Spin7/Self_Balance_Robot_via_Feedback_State/3- Latex ZIP Projects/TPF_SCD_RobotBalancin_extracted/abstract.tex

In this final work, a model-based predictive control (MBPC) strategy is proposed for three-phase inverters in order to control the power delivered to the balanced/linear loads  for applications in distributed generation. Contrary to the classical control schemes, the proposed method does not require current proportional-integral controllers or a complex modulation stage. The discrete-time model of the inverter, filter and load are used to predict the future behavior of the load currents for each of the possible switching states. The proposed predictive method chooses a switching state that minimizes the error between the output currents and their references. The feasibility of the proposed method is verified in this first part, through simulation results, evaluating these results using performance parameters. The results obtained through simulations are compared with those obtained experimentally using a test platform designed as part of the final work. These results validate the excellent dynamic performance and efficiency of the proposed methods.
