Spin7/Self_Balance_Robot_via_Feedback_State/TPF_SCD_RobotBalancin.pdf

## Trabajo Practico Final ´ SISTEMAS DE CONTROL DIGITAL

Control de un Robot Balancín (Pendulo Invertido) Mediante Retroalimentaci ´ | on de Estados ´

Lucas Pina,1, Matteo Martineza,1, Franco de Vargasa,1, Dr. Ing. Leonardo Comparatoreb,1, MSc. Ing. Christian Medinab,1, MSc. Ing. Paola Maidanab,1

aEstudiante de Ingeniería Mecatrónica, Facultad de Ingeniería, Universidad Nacional de Asunción, CITEC-Luque, Paraguay
bOrientador, Facultad de Ingeniería, Universidad Nacional de Asunción, CITEC-Luque, Paraguay

Palabras clave

Control Optimo
LQR
Servo Sistema
Pendulo Invertido

Resumen

Se desarrolla el modelado y control de un robot balancín, considerado como un pendulo invertido ´
sobre ruedas. Se parte de la obtencion del modelo din ´ | amico mediante la formulaci ´ | on de Lagrange, ´
representando el sistema como cuerpos rígidos acoplados. Luego, se disena un controlador ˜ | optimo ´
LQR basado en realimentacion de estados, con el objetivo de estabilizar la posici ´ | on vertical ´
del sistema. Finalmente, se valida el desempeno del controlador en simulaci ˜ | on, demostrando su ´
efectividad ante distintas condiciones iniciales.

### 1. Introduccion´

“¡Contempla, caminante del filo, la danza de un cuerpo erguido contra la tiranía de la gravedad!”.

El control de sistemas inestables ha sido un tema central en la teoría de control moderno, destacando el pendulo ´ invertido como uno de los problemas mas representativos por ´ su naturaleza altamente no lineal y su inestabilidad inherente. En este contexto, el robot balancín, tambien conocido como ´ self-balancing robot, ofrece una excelente plataforma para estudiar tecnicas de control avanzadas aplicadas a un sistema ´ real.
El objetivo principal de este trabajo es disenar e implementar ˜ un controlador que permita mantener el equilibrio de un robot de dos ruedas con estructura vertical, utilizando retroalimentacion de estados. Para ello, se parte de un ´ modelado físico detallado de la planta, representando las distintas masas y componentes mecanicos como cuerpos ´ rígidos acoplados. A partir de este modelo, se derivan las
ecuaciones dinamicas mediante el m ´ | etodo de Lagrange-Euler, ´
identificando las principales variables de estado que influyen en el comportamiento del sistema.
Una vez modelado el sistema, se procede al diseno de ˜
un controlador optimo mediante la t ´ | ecnica LQR (Linear ´
Quadratic Regulator), que busca minimizar una funcion de ´
costo cuadratica asociada al desempe ´ | no del sistema. ˜
La implementacion f ´ | ísica se realizo sobre plataforma ´
Arduino, incorporando sensores como giroscopio, acelerometro ´ y tacometros para estimar las variables de estado. El control se ´
aplico con un driver L298N usando se ´ | nal PWM. ˜
Finalmente, se validan los resultados obtenidos tanto en simulaciones como en la implementacion f ´ ísica del prototipo, evaluando la efectividad del control ante distintas condiciones de operacion. ´
2. Descripcion de la Planta y Modelado Matem ´ | atico ´
2.1. Descripción de la Planta
El fenomeno f ´ | ísico del robot balancín se aproxima como un
modelo de cuerpos rígidos acoplados, el cual consisten en dos cilindros huecos que pueden girar completamente sobre su eje (representando las ruedas), y tres prismas de masa m1, m2 y m3 (figura 1), donde la distancia perpendicular fija desde el centro de masa de estos prismas respecto al eje donde giran las ruedas (siendo este la referencia y = 0) esta dado por h1, h2 y h3, como se observa en la figura 2.

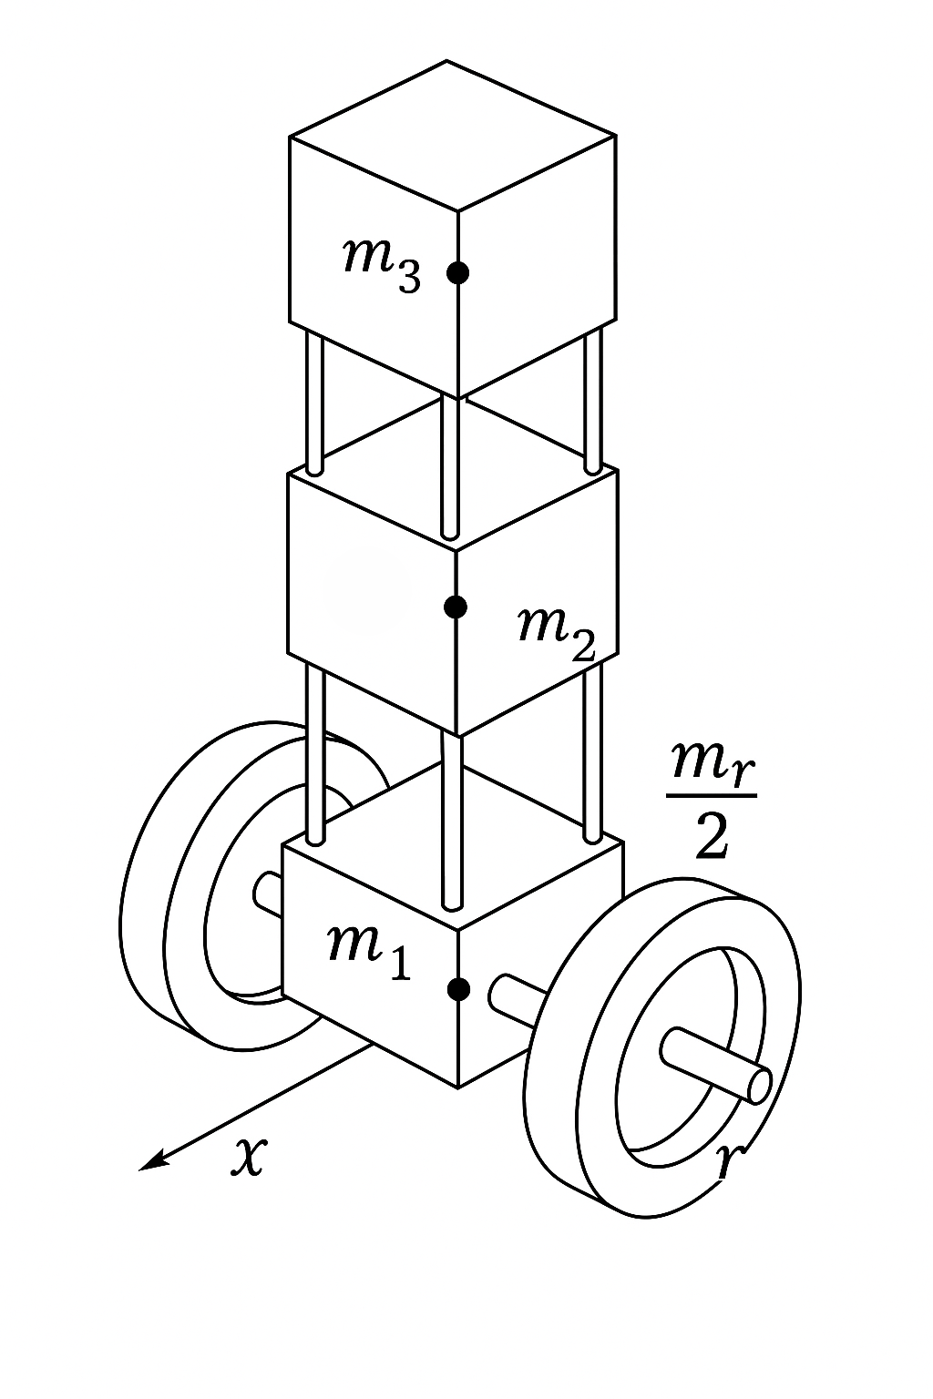
[picture p2: figure]

Fig. 1. Esquema Tridimensional de la Planta.

Las consideraciones tomadas para obtener sus ecuaciones dinamicas son: ´
- Los cilindros ruedan sin deslizar y ademas ambos tienen el mismo desplazamiento lineal en todo momento.
Facultad de Ingeniería - UNA | 30 de junio de 2025

Control de un Robot Balancín (Péndulo Invertido) Mediante Retroalimentación de Estados

- El eje de los cilindros y los primas estan acoplados ´ rígidamente entre si.
- La distribucion de masas esta sim ´ | etricamente distribuido ´
tal que el centro de masas de los cilindros queda en un plano normal al eje de las ruedas que pasa por el punto medio del mismo.

Estas suposiciones permiten limitar la dinamica del ´ fenomeno a un movimiento bidimensional. ´

2.2. Modelado | Matemático | por | las | ecuaciones | de
Lagrange-Euler

Para obtener las ecuaciones de su dinamica de movimiento ´ se empleo la formulacion de Langrange-Euler. Las coordenadas ´ generalizadas para este enfoque fueron tomadas como q1 = x y q2 = θ, donde x es la distancia horizontal de del centro del eje de las ruedas y θ es el angulo del pendulo medido desde la ´ vertical, como se observa en la figura 2.

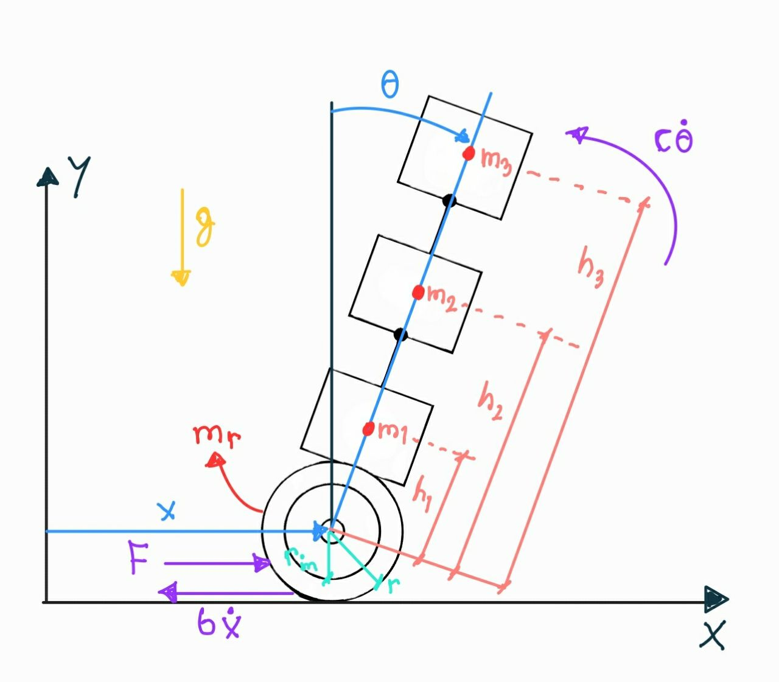
[picture p3: figure]

Fig. 2. Esquema Simplificado en el Plano.

Obtención de la Expresión de la Energía Cinética:

⇒ Energía Cinetica de las ruedas (ruedas en rotaci ´ | on sin ´
deslizamiento):
- Masa de Cada Rueda: mr/2.
- Energía transaccional: 1
2

(mr/2) ẋ

2
- Energía rotacional (eje propio): 1
2

Ir( ẋ/r)

2
, con Ir =
1/2(mr/2)(r + rint)

2
Entonces la energía cinetica de las ruedas est ´ | a dada por ´

Truedas = 2

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
mr x˙

2

⇒ Energía de la estructura de prismas (plataformas) Para cada prisma (plataforma) i ∈ {1, 2, 3} :
- Masa: mi
- Distancia del CM al centro del eje de las ruedas: hi .
- Posicion del CM: ´ | xi = x + hisen(θ), yi = hicos(θ).
- Velocidad total del CM:

vi =

dxi

dt !2
+

dyi

dt !2
=
x˙ + hicos(θ)θ˙

2
+
−hisen(θ)θ˙

2

Desarrollando la expresion: ´

vi = x˙

2 + 2hix˙θċos(θ) + h

2
i

θ˙

2

Entonces, energía cinetica total de los prismas es: ´

Tprismas =

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
Tprismas =

1
2
x˙

2X

3

i=1

mi + 2 ẋθċos(θ)

X

3

i=1

mihi + θ˙

2X

3

i=1

mih

2
i

Donde:
- mT =
P
mi
- Mh =
P
mihi
- Ih =
P
mih

2
i

⇒ Energía Cinetica Total del Sistema: ´

T = Truedas + Tprismas

T =

1
2

mT +

3
2

mr

!
x˙

2 + Mh x˙θċos(θ) +

1
2

Ihθ˙

2

Obtención de la Expresión de la Energía Potencial:

Para el sistema considerado, la energía potencial estada solo por la energía potencial gravitacional de las masas, esto es:

V =

X

3

i=1

mihig · cos(θ) = C1cos(θ)

Donde g es la aceleracion debido a la gravedad y ´ C1 =

P
mihig.

Obtención del Lagrangiano:

El Lagrangiano esta dado por:

L = T − V

Entonces:

L =

1
2

Mx˙

2 + Mh x˙θċos(θ) +

1
2

Ihθ˙

2 − C1cos(θ)

Donde M =

mT +

3
2mr

Ecuaciones de Lagrange-Euler:

⇒ Para q1 = x

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
= −bx˙ + F

Donde b es friccion lineal y ´ | F la fuerza neta aplicada en x.

⇒ Para q2 = θ

d
dt

∂L
∂θ˙

!
| − ∂L ∂θ = −cθ˙

Donde c es la friccion angular. ´

Ecuaciones de Movimiento del Sistema:

(1) Mx¨ + Mhcos(θ)θ¨ = F − bx˙ + Mh sin(θ)θ˙

2

(2) Ihθ¨ + Mhcos(θ) ẍ = C1 sen(θ) − cθ˙

Linealización del Sistema:

Para poder llevar la expresion de la planta al espacio de ´ estados, se requiere de una linealizacion previa. Considerando ´
la linealizacion al redero del punto de equilibrio ´ | θ = 0, se tiene:
- cos(θ) ≈ 1.
- sen(θ) ≈ θ.
- θ˙² ≈ 0.

Entonces, el sistema linealizado queda como:

(1′
) Mx¨ + Mhθ¨ = F − bx˙
(2′
) Ihθ¨ + Mh x¨ = C1θ − cθ˙

Tomando los estados como:

X =

h
x1 | x2 | x3 | x4

iT
=

h
x x˙ θ θ˙

iT

Es necesario conseguir las variables ẍ y θ¨ de (1′
) y (2′
) en
funcion de las variables de estados ´ | x1, | x2, | x3 y x4. Esto es
posible resolviendo la ecuacion matrical dada por:
"
M | Mh
Mh | Ih

# "x¨

θ¨
=

"
F − cx˙
C1θ − cθ˙

Dando como resultado:

x¨ = −

Ihb
∆

x˙ +

MhC1
∆

θ −

Mhc
∆

θ˙ +

Ih
∆

u

θ¨ =

Mhb
∆

x˙ +

MC1
∆

θ −

Mc
∆

θ˙ −

Mh
∆

u

Donde:

- ∆ = MIh − M²
h

y F = u el esfuerzo de control.

Forma en el Espacio de Estados:

X = AX˙ + Bu

Donde las matrices A y B estan dadas por: ´

A =

0 | 1 | 0 | 0
0 − | Ihb
| ∆ | MhC1
| | ∆

−

| | | Mhc
| | | ∆
0 | 0 | 0 | 1
0 | Mhb
| ∆ | MC1
| | ∆

−

| | | Mc
| | | ∆

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
### 3. Diseno del Controlador ˜

3.1. Definición del Espacio de Estados Continuo
1 | % % 1. MODELADO DE LA PLANTA
2 | % Masas de los componenetes en kg
3 | m_bateria = 0.125; % Masa de la bateria
4 | m_arduino = 0.025; % Masa del Arduino Uno
5 | m_driver = 0.025; % Masa del driver L298n
6 | m_MPU = 0.002; % Masa del sensor MPU
7 | m_tacometro = 0.04; % Masa de cada tacometro + su disco
8 | m_rueda = 0.029; % Masa de cada rueda
9 | m_motor = 0.034; % Masa de cada motor

10
11 | g = 9.8; % Aceleracion de la gravedad [m/s^2]
12 | b = 0.1; % Fricion Lineal
13 | c = 0; % Fricion Angular (Despreciado)
14 | % --- PARAMETROS (1)---
15 | % Datos de la rueda
16 | mr = 2*m_rueda;
17 | r = 3.4/100;
18 | r_int = 2.5/100;
19 | Ir = (1/2)*m_rueda*(r^2+r_int^2); %Momento de Inercia

20
21 | % Datos del prima 1 (Bateria + Motores)
22 | m1 = m_bateria + 2*m_motor + 2*m_tacometro;
23 | h1 = 0.1/100;

24
25 | % Datos del prima 2 (Arduino + Drivers)
26 | m2 = m_arduino + m_driver;
27 | h2 = 5.2/100;

28
29 | % Datos del prima 3 (Sensor MPU)
30 | m3 = m_MPU;
31 | h3 = 10/100;

32
33 | % --- PARAMETROS SIMPLIFICADOS---
34 | mT = m1 + m2 + m3;
35 | Mh = m1*h1 + m2*h2 + m3*h3;
36 | Ih = m1*h1^2 + m2*h2^2 + m3*h3^2;
37 | M = mT + (3/2)*mr;
38 | C1 = g*Mh;
39 | delta = M*Ih-Mh^2;
40 | % % 2. DEFINICION DEL MODELO EN ESPACIO DE ESTADOS
41 | a11 = 0;
42 | a12 = 1;
43 | a13 = 0;
44 | a14 = 0;

45
46 | a21 = 0;
47 | a22 = -(Ih*b)/delta;
48 | a23 = (Mh*C1)/delta;
49 | a24 = -(Mh*c)/delta;

50
51 | a31 = 0;
52 | a32 = 0;
53 | a33 = 0;
54 | a34 = 1;

55
56 | a41 = 0;
57 | a42 = (Mh*b)/delta;
58 | a43 = (M*C1)/delta;
59 | a44 = -(M*c)/delta;

60
61 | b1 = 0;
62 | b2 = (Ih)/delta;
63 | b3 = 0;
64 | b4 = -(Mh)/delta;

65
66 | A = [a11 a12 a13 a14;
67 | a21 a22 a23 a24;
68 | a31 a32 a33 a34;
69 | a41 a42 a43 a44]; % matriz A del sistema
70 | B = [b1 b2 b3 b4]’; % matriz B del sistema
71 | C = [1 0 0 0]; % tomando como entrada x
72 | D = 0;

Teniendo como resultado las matrices:

A =

0 | 1,0000 | 0 | 0
0 −0,2847 | 1,6946 | 0
0 | 0 | 0 | 1,0000
0 | 5,6270 | 227,1964 | 0

B =

0
2,8469
0
−56,2702

Y tomando la el estado x1 = x (esto es debido que esto es la unica combinacion que hace posible que el sistema sea observable), la distancia lineal, la matriz C queda como:

C =

h

1 0 0 0i
y D = 0
3.2. Metodo de Discretizacion
Para la discretizacion se tomo un tiempo de muestro de ´ T s = 10 ms, adecuado para su implementacion en placas ´
de desarrollo como Arduino. El metodo de discretizaci ´ | on´
usado fue el ZOH (Zero-Order Hold) esto es debido a que refleja fielmente el comportamiento de como se mantienen ´ constantes las senales de control entre actualizaciones en ˜ sistemas digitales reales.
1 | % % 2. DISCRETIZACIN
2 | Ts = 0.01; % Tiempo de muestreo 10ms

3
4 | sys_C = ss(A,B,C,D); % Planta Continua
5 | sys_D = c2d(sys_C, Ts, ’zoh’); % Planta Discreta

6
7 | % Matrices en el Espacio de Estado Discreto
8 | G = sys_D.A;
9 | H = sys_D.B;
10 | C = sys_D.C;
11 | D = sys_D.D;

Teniendo como resultado las matrices en el espacio de estados discreto:

G =

1,0000 0,0100 0,0001 0,0000
0 | 0,9972 0,0170 0,0001
0 | 0,0003 1,0114 0,0100
0 | 0,0564 2,2811 1,0114

H =

0,0001
0,0284
−0,0028
−0,5640

Teniendo el sistema discreto se puede comprobar que cumple con ser completamente controlable y es observable solo cuando se toma como entrada de retroalimentacion la ´
posicion lineal ´ | x (el cual es el caso estudiado en este trabajo).
3.3. Diseño y Calculo del Controlador
El sistema dado nos permite disenar un servo sistema ˜ observable. Debido que la retroalimentacion debemos hacerlo ´
con la posicion lineal ´ | x para poder observar las demas variables ´
y esta no podemos medirla directamente (se requiere de
una integracion num ´ | erica de las lecturas obtenidas por los ´
taco-metros de las ruedas) y demas la calidad de estimaci ´ | on del ´
observador depende de la fidelidad del modelo físico empleado se opto por usar un servo sistema sin observador.

El calculo de para la matriz K de retroalimentacion de estados ´ fue realizado usando el metodo ´ LQR (linear Quadratic Regulator)

1 | % % 4. DISENO DE LA REALIMENTACION DE ESTADOS
2 | % Penalizacin alta para x y theta
3 | Q = diag([200, 10, 200, 20]);
4 | R = 1; % Penalizacin para el esfuerzo de control

5
6 K = dlqr(G,H,Q,R);

Teniendo como resultado:

K =

h

−4,7152 − 3,3278 − 17,0580 − 1,8229i

3.4. Ecuación en Diferencias que Define al Sistema Retroalimentado
La dinamica de los estados se actualiza seg ´ | un la siguiente ´
expresion: ´
X[k + 1] = GX[k] + H(−KX[k]) Siendo el esfuerzo de control:

u[k] = −KX[k]

3.5. Resultados de la Simulación
A continuacion se muestran los resultados de la ´ respuesta del sistema sin retroalimentacion de estados y ´
con retroalimentacion de estados. Para una inclinaci ´ | on de ´
θ = 10◦ ≈ 0,1745 rad. Siendo entonces el estado inicial:

X[0] =

x1[0]
x2[0]
x3[0]
x4[0]

=

0
0
0,1745
0

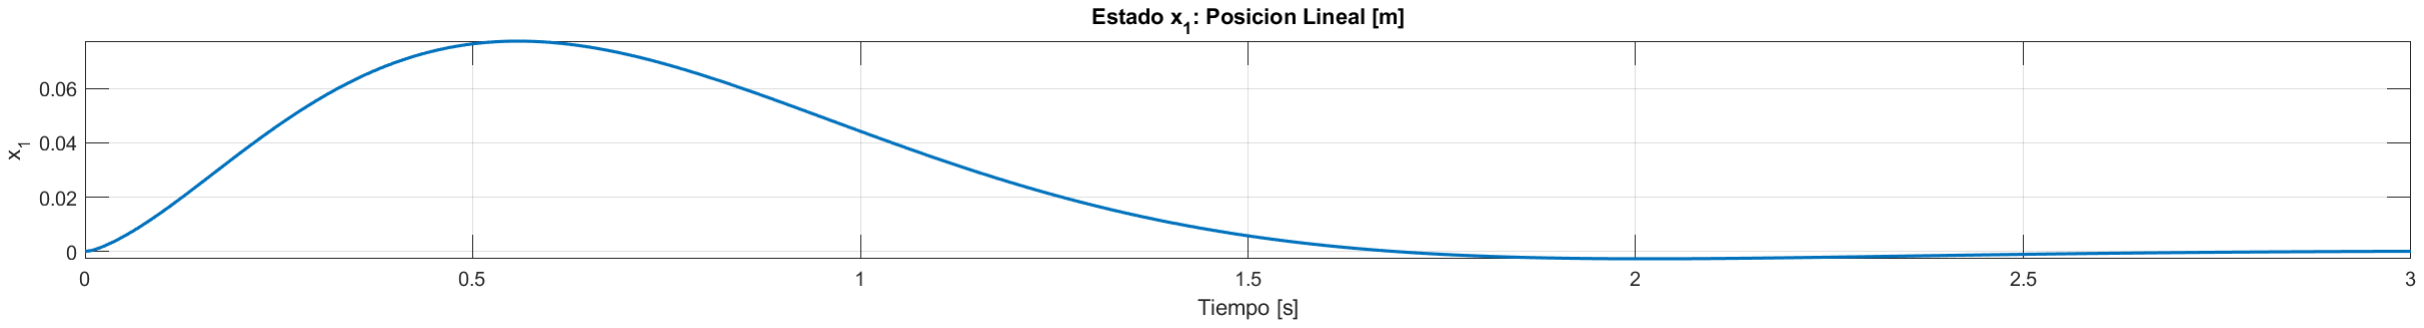
[picture p4: figure]

Fig. 3: Evolucion de posici ´ | on lineal [ ´ | m] a una inclinacion inicial de 10 ´

◦
con
retroalimentacion de estados ´

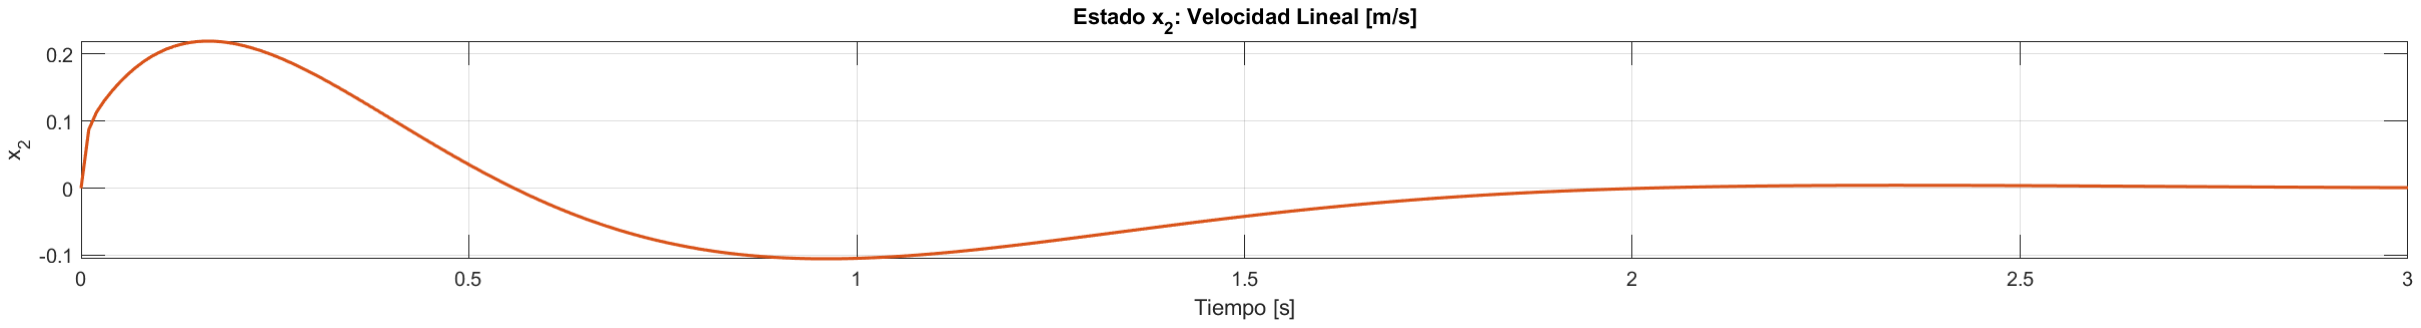
[picture p5: figure]

Fig. 4: Evolucion de velocidad lineal [ ´ | m/s] a una inclinacion inicial de 10 ´

◦
con
retroalimentacion de estados ´

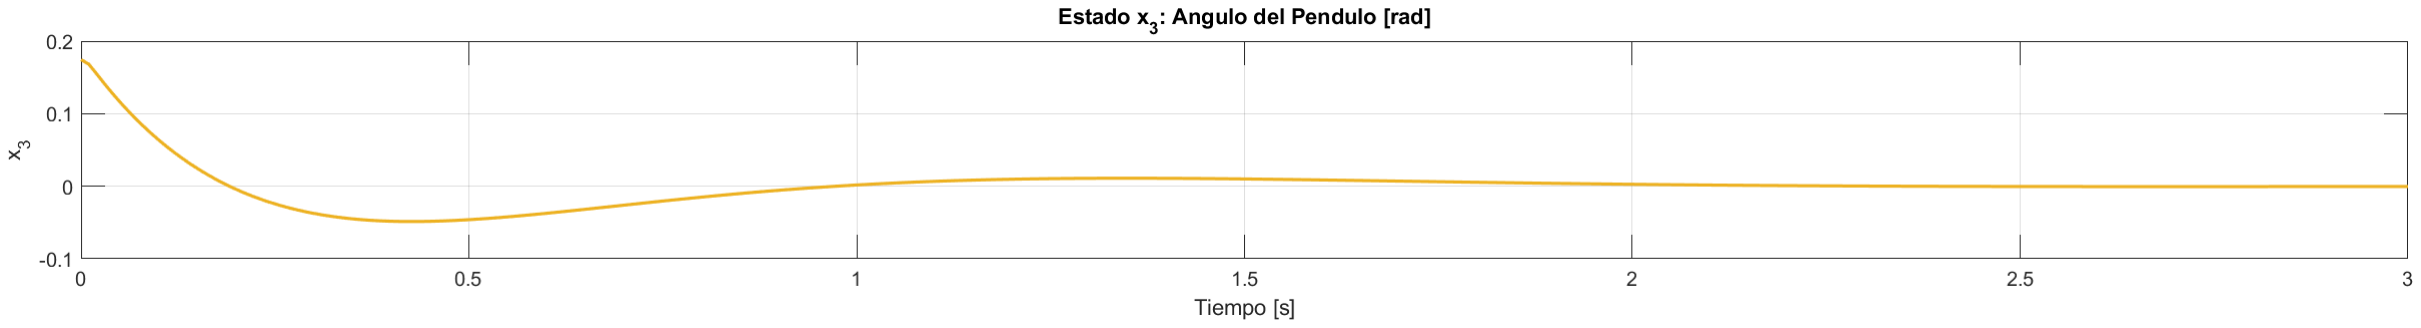
[picture p6: figure]

Fig. 5: Evolucion del angulo del p ´ | endulo [ ´ | rad] a una inclinacion inicial de 10 ´

◦
con retroalimentacion de estados ´

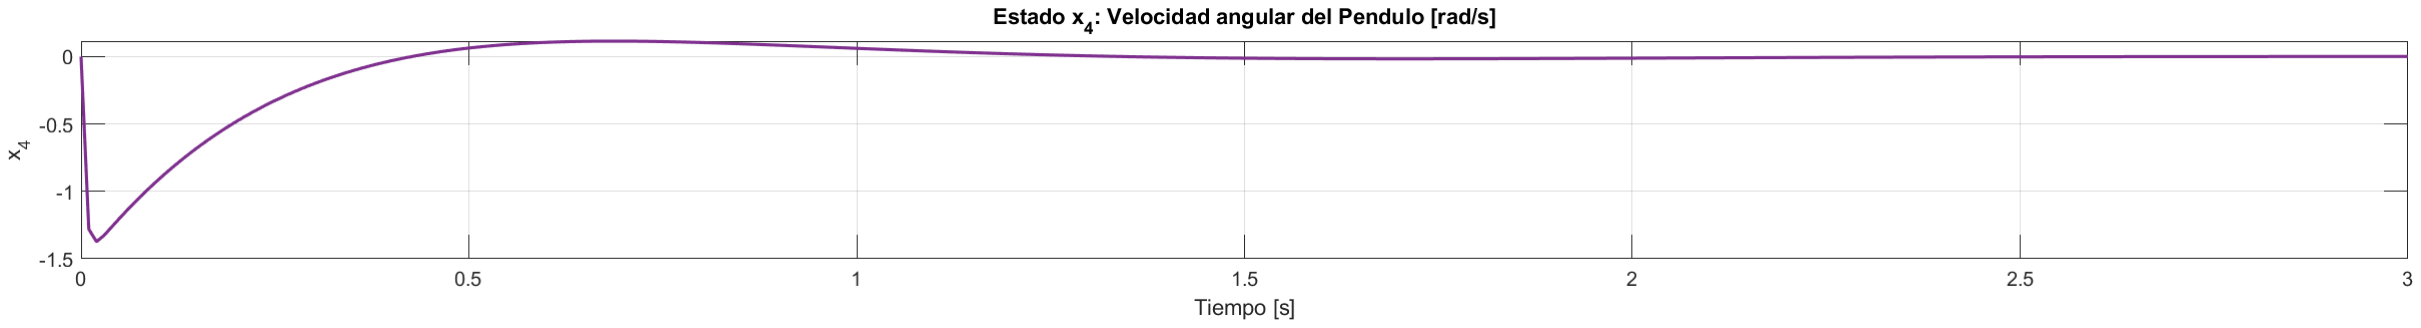
[picture p7: figure]

Fig. 6: Evolucion de la velocidad angular del p ´ | endulo [ ´ | rad/s] a una inclinacion´
inicial de 10◦
con retroalimentacion de estados ´

4. Implementacion del Controlador en el Robot Balanc ´ | ín
4.1. Sensores y Drivers Usados

Para la estimacion de las variables de estado del sistema ´ se utilizaron tres sensores: un giroscopio, un acelerometro y ´ dos tacometros (uno por cada rueda). La velocidad lineal del ´ sistema se obtuvo a partir del promedio de las velocidades angulares de los tacometros, multiplicado por el radio de las ´
ruedas. La posicion lineal fue estimada mediante integraci ´ | on´
numerica de dicha velocidad. ´
El angulo del p ´ | endulo se obtuvo principalmente del ´
giroscopio. Sin embargo, para reducir el error y el ruido en la
medicion, se aplic ´ | o un filtro de Kalman 1D combinando los ´
datos del acelerometro, seguido de un filtro complementario ´
para suavizar la senal. La velocidad angular del p ˜ | endulo fue ´
estimada a partir de estas senales mediante integraci ˜ | on y filtrado ´
adicional.
El control de los motores se implemento mediante un driver ´ L298N, donde la entrada PWM corresponde al esfuerzo de control u generado por el controlador, previamente escalado. Esto permite controlar tanto la direccion como la magnitud del ´ movimiento del sistema.
4.2. Implementación del Controlador en Arduino
1 | void loop() {
2 | /// DEFINICION DE LA K DE RETROALIMENTACION ////
3 | float k1 = -4.7152;
4 | float k2 = -3.3278;
5 | float k3 = -17.0580;
6 | float k4 = -1.8229;

7
8 | /// OBTENCION DE LAS VARIABLES DE ESTADOS ////
9 | gyro.update(); // Aactualiza la lectura del Giroscopio
10 | // Obtiencion del angulo theta
11 | float Pitch_angle = gyro.get_PitchAngle();

12
13 | // Obtencion de la velocidad angular del pendulo:
14 | float Pitch_rate = gyro.get_PitchAngle_Rate();
15 | // Filtro Complementario para el angulo
16 | Pitch_rate = (0.6* Pitch_rate+ (1-0.6)*prev_Pitch)-3;
17 | prev_Pitch= Pitch_rate;

18
19 | tacoA.update(); // Acutiliza el tacametro de la rueda A
20 | tacoB.update(); // Acutiliza el tacametro de la rueda B
21 | // Toma la velocidad como el promedio
22 | float w_ruedas = (tacoA.get_angular_rate()+
23 | tacoB.get_angular_rate())/2;
24 | // Velocidad lineal de las ruedas
25 | float v_lineal = w_ruedas*(3.4/100);

26
27 | integrador.setVelocity(sing*v_lineal);
28 | integrador.update();
29 | // La posicion se cosigue integrando la velocidad
30 | float x = integrador.getPosition();

31
32 | /// LEY DE CONTROL ////
33 | // Muestereo de 10 ms
34 | if (millis() - t_ant >= 10){

35
36 | t_ant = millis();

37
38 | // Calculo del esfuerzo de control
39 | u =-(x*k1+v_lineal*k2+Pitch_angle*k3+Pitch_rate*k4);

40
41 | }

42
43 | // Control de los motores con u
44 | Control_Motors(u);
45 | }
4.3. Resultados de la Implementación

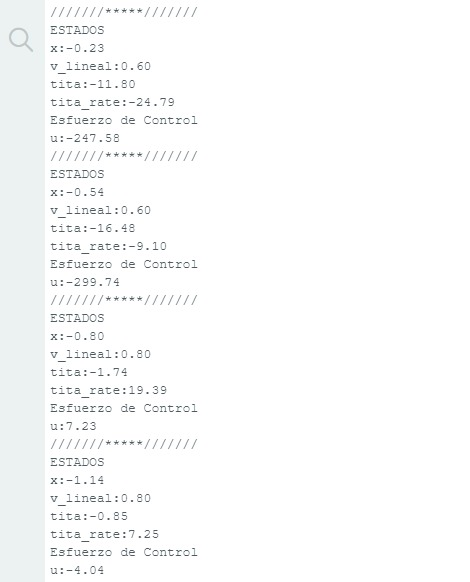
[picture p8: figure]

Fig. 7. Resultados de la Implementacion en Arduino ( ´ | θ medido en grados)

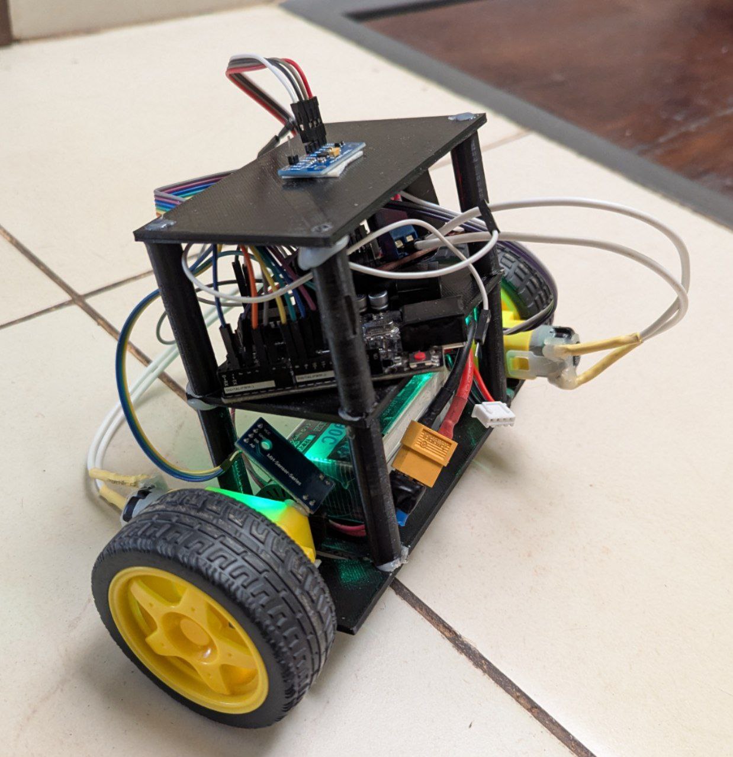
[picture p9: figure]

Fig. 8. Robot Balancín Prototipo “Paco”

### 5. Conclusiones

Este trabajo logro dejar en evidencia la eficacia de los
metodos modernos de control, tal como es la retroalimentaci ´ | on´
de estados y tiene gran importancia en sistemas del tipo MISO que ademas sean inherentemente inestables, como es el caso del Robot Balancín, estos mismos sistemas tienen un control pobre
o nulo con tecnicas de control cl ´ | asicas como es el PID la cual es ´
un control pensado exclusivamente para sistemas del tipo SISO.

### 6. Referencias

[1] Katsuhiko Ogata. Discrete-Time Control Systems. 2nd ed., Prentice Hall, Upper Saddle River, New Jersey, 1995.
[2] Ramírez-Gonzalez, L., Garc ´ | ía-Martínez, J., Siordia-Vasquez, X. y ´
Garcia-Ramos, R. (2017). Euler-Lagrange en el modelado y control de un péndulo invertido sobre un carro. Revista de Ingeniería Electrica, 1(3), ´ 1–8. ECORFAN.
