Spin7/Self_Balance_Robot_via_Feedback_State/3- Latex ZIP Projects/TPF_SCD_RobotBalancin_extracted/resumen.tex

Se desarrolla el modelado y control de un robot balancín, considerado como un péndulo invertido sobre ruedas. Se parte de la obtención del modelo dinámico mediante la formulación de Lagrange, representando el sistema como cuerpos rígidos acoplados. Luego, se diseña un controlador óptimo LQR basado en realimentación de estados, con el objetivo de estabilizar la posición vertical del sistema. Finalmente, se valida el desempeño del controlador en simulación, demostrando su efectividad ante distintas condiciones iniciales.
