Spin7/Self_Balance_Robot_via_Feedback_State/3- Latex ZIP Projects/TPF_SCD_RobotBalancin_extracted/imagenes/LogoFiuna.pdf

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

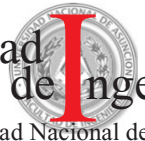
[picture p10: figure]
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
