Spin7/Self_Balance_Robot_via_Feedback_State/3- Latex ZIP Projects/TPF_SCD_RobotBalancin_extracted/imagenes/hola.jpg

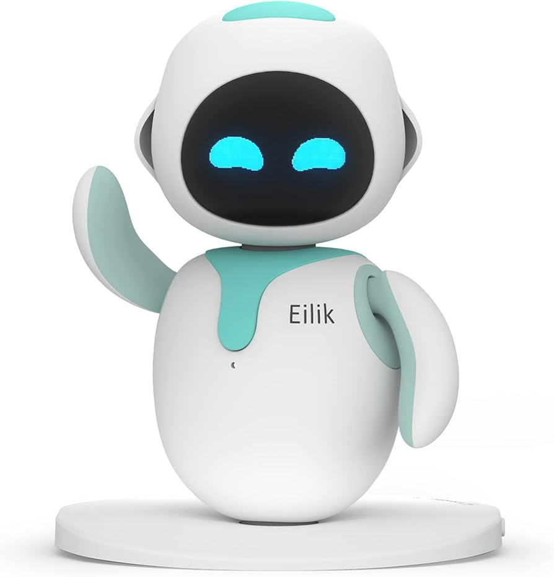
3- Latex ZIP Projects/TPF_SCD_RobotBalancin_extracted/imagenes/hola.jpg
