Spin7/Self_Balance_Robot_via_Feedback_State/2- Arduino/Drivers_and_Sensors_Class/Taco_Class_test/Taco_Class_test.ino

#include "Taco.h"

//Taco taco(12, 20);  // pin 12, 20 pulses per revolution
Taco tacoA(2, 20);

void setup() {
  Serial.begin(115200);
  tacoA.begin();
}

void loop() {
  

  tacoA.update();
  Serial.print(" | Vel. angular: ");
  Serial.print(tacoA.get_angular_rate());
  Serial.println(" rad/s");

  delay(100);
}
